tinyfpga/TinyFPGA-EX/README.md

# TinyFPGA-EX
Small, but powerful FPGA development board based on the Lattice ECP5.
