tinyfpga/TinyFPGA-EX/board/TinyFPGA-EX.kicad_pcb

## KiCad design board/TinyFPGA-EX.kicad_pcb (2019-02-04)

Schematic: TinyFPGA-EX.sch

Parts:
C1, C17, C20, C42, C43: 1uF; C_0402_NoSilk
C2, C3, C6, C9, C10, C13, C15, C18, C24, C26, C28, C29, C30, C34, C39, C41, C44, C45, C46, C47: 100nF; C_0402_NoSilk
C4, C7, C11, C12, C14, C16, C31, C35: 10nf; C_0402_NoSilk
C5, C23: 10uF; C_0603
C8, C38, C40: 10nF; C_0402_NoSilk
C19: 2.2uF; C_0402_NoSilk
C22: 22uF; C_0603
C33: 10uF; C_0402_NoSilk
C36, C37: 1nF; C_0402_NoSilk
D1, D2: LED; LED_0603
J1: Conn_02x03_Odd_Even
J2: Micro_SD_Card_Det_Hirose_DM3AT; DM3D-SF
J3: USBC
J4, J5: Conn_01x24; Pin_Header_Straight_1x24_Pitch2.54mm
J6: Conn_02x09_Odd_Even
J7: Conn_01x06
L1: 330nH; L_Vishay_IHLP-1616
L2: 1uH; L_Wuerth_MAPI-2010
R3, R8: 0; R_0402_NoSilk
R4, R5, R7, R10: 4.7k; R_0402_NoSilk
R6: 100K; R_0402_NoSilk
R11: 1.5k; R_0402_NoSilk
R12, R13: 4.7K; R_0402_NoSilk
SW1: SW_Push; PTS_810_SMT_Switch
TP1, TP11, TP12, TP13: TEST; small-testpoint
U1: LFE5UM-285
U2: S27KS0641DPBHI020; FBGA-24
U3: DSC6001CI2A-016.0000T; CDFN3225-4LD-PL-1
U4: FAN53555; WLCSP-20
U5: MIC5504-2.5YMT-TR; Thin-DFN4
U6: Conn_02x03_Counter_Clockwise
U7: FAN53600; WLCSP-6
U8: S25FL064L; UNF008
U9: MIC5504-1.2YMT-TR; Thin-DFN4
U10, U11: PUSB3FR4Z

Connections:
+1V1: C10.1, C12.1, C13.1, C14.1, C15.1, C16.1, C22.1, L1.2, U1.C8, U1.C9, U1.C10, U1.C11, U1.D8, U1.D9, U1.D10, U1.D11, U1.J3, U1.J4, U1.J5, U1.J14, U1.J15, U1.J16, U1.K3, U1.K4, U1.K15, U1.K16, U1.L3, U1.L4, U1.L15, U1.L16, U1.M3, U1.M4, U1.M15, U1.M16, U1.P7, U1.P9, U1.P11, U4.A4; also elsewhere on the board
+1V2A: C36.1, C37.1, C38.1, C39.1, C40.1, C41.1, C43.1, TP1.1, U1.P10, U1.R10, U1.T5, U1.U6, U1.U8, U1.U12, U9.1
+2V5: C6.1, C7.1, C20.1, TP13.1, U1.E6, U1.E13, U1.N6, U1.P5, U1.P13, U1.R3, U5.1
+5V: C5.1, C8.1, C19.1, J3.A4, J3.A9, J3.B4, J3.B9, J5.1, R3.1, U4.A2, U4.D1, U4.D2, U4.E1, U4.E2, U7.A2, U7.B2
CC1: J3.A5
CC2: J3.B5
CFG_MODE_SEL_0: R7.1, U1.U14, U1.V15
CFG_MODE_SEL_1: R5.2, U1.T14
CH0_RXN: J3.A10, U1.V8, U10.2, U10.9
CH0_RXP: J3.A11, U1.V9, U10.1, U10.10
CH0_TXN: C47.2, U1.V11, U11.2, U11.9
CH0_TXP: C45.2, U1.V12, U11.1, U11.10
CH1_RXN: J3.B11, U1.V5, U11.5, U11.6
CH1_RXP: J3.B10, U1.V6, U11.4, U11.7
CH1_TXN: C46.2, U1.V2, U10.5, U10.6
CH1_TXP: C44.2, U1.V3, U10.4, U10.7
CLK_16MHz: U1.B17, U3.3
CSSPIN: U1.U17, U8.1; also elsewhere on the board
DONE: U1.U15
GND: C1.2, C2.2, C3.2, C4.2, C5.2, C6.2, C7.2, C8.2, C9.2, C10.2, C11.2, C12.2, C13.2, C14.2, C15.2, C16.2, C17.2, C18.2, C19.2, C20.2, C22.2, C23.2, C24.2, C26.2, C28.2, C29.2, C30.2, C31.2, C33.2, C34.2, C35.2, C36.2, C37.2, C38.2, C39.2, C40.2, C41.2, C42.2, C43.2, J1.3, J2.6 (VSS), J2.11 (SHIELD), J3.A1, J3.A12, J3.B1, J3.B12, J4.1, J5.2, J5.15, J6.1, R4.2, R6.2, R7.2, R8.2, R12.2, R13.2, SW1.1, U1.B3, U1.B16, U1.E5, U1.E7, U1.E8, U1.E9, U1.E10, U1.E11, U1.E12, U1.E14, U1.F5, U1.F6, U1.F7, U1.F8, U1.F9, U1.F10, U1.F11, U1.F12, U1.F13, U1.F14, U1.G2, U1.G6, U1.G7, U1.G8, U1.G9, U1.G10, U1.G11, U1.G12, U1.G13, U1.G17, U1.H6, U1.H7, U1.H8, U1.H9, U1.H10, U1.H11, U1.H12, U1.H13, U1.J6, U1.J7, U1.J8, U1.J9, U1.J10, U1.J11, U1.J12, U1.J13, U1.K5, U1.K6, U1.K7, U1.K8, U1.K9, U1.K10, U1.K11, U1.K12, U1.K13, U1.K14, U1.L2, U1.L5, U1.L6, U1.L7, U1.L8, U1.L9, U1.L10, U1.L11, U1.L12, U1.L13, U1.L14, U1.L17, U1.M6, U1.M7, U1.M8, U1.M9, U1.M10, U1.M11, U1.M12, U1.M13, U1.N7, U1.N8, U1.N9, U1.N10, U1.N11, U1.N12, U1.P6, U1.P8, U1.P12, U1.R1, U1.R2, U1.T2, U1.T3, U1.T4, U1.T6, U1.T7, U1.T8, U1.T9, U1.T10, U1.T11, U1.T12, U1.T16, U1.U2, U1.U3, U1.U4, U1.U5, U1.U7, U1.U9, U1.U10, U1.U11, U1.V4, U1.V7, U1.V10, U2.B3, U2.C1, U2.E5, U3.2, U4.A3, U4.B1, U4.B2, U4.B3, U4.B4, U4.C1, U4.C2, U4.C3, U4.C4, U5.2, U6.3, U7.A1, U7.C2, U8.4, U9.2, U10.3, U10.8, U11.3, U11.8
INITN: U1.V16
IO2: U1.R18, U8.3
IO3: U1.N18, U8.7
MISO: U1.T18, U8.2; also elsewhere on the board
MOSI: U1.U18, U8.5; also elsewhere on the board
unnamed: C44.1, J3.A3
unnamed: C45.1, J3.B2
unnamed: C46.1, J3.A2
unnamed: C47.1, J3.B3
unnamed: D1.1, R12.1
unnamed: D2.1, R13.1
unnamed: L1.1, U4.D3, U4.D4, U4.E3, U4.E4
unnamed: L2.1, U7.B1
unnamed: R3.2, R8.1, U4.A1
PIN1: J4.2, U1.F18
PIN2: J4.3, U1.H17
PIN3: J4.4, U1.H18
PIN4: J4.5, U1.J17
PIN5: J4.6, U1.N17
PIN6: J4.7, U1.M18
PIN7: J4.8, U1.M17
PIN8: J4.9, U1.G18
PIN9: J4.10, U1.D18
PIN10: J4.11, U1.B18
PIN11: J4.12, U1.A17
PIN12: J4.13, U1.A16
PIN13: J4.14, U1.B15
PIN14: J4.16, U1.A15
PIN15: J4.17, U1.A13
PIN16: J4.18, U1.B13
PIN17: J4.19, U1.D15
PIN18: J4.20, U1.C15
PIN19: J4.21, U1.A11
PIN20: J4.22, U1.B11
PIN21: J4.23, U1.A12
PIN22: J4.24, U1.B12
PIN23: J5.24, U1.B8
PIN24: J5.23, U1.B7
PIN25: J5.22, U1.C4
PIN26: J5.21, U1.B1
PIN27: J5.20, U1.A3
PIN28: J5.19, U1.C2
PIN29: J5.18, U1.C1
PIN30: J5.17, U1.D1
PIN31: J5.16, U1.D3
PIN32: J5.14, U1.R17
PIN33: J5.13, U1.V17
PIN34: J5.12, U1.R16
PIN35: J5.11, U1.J18
PIN36: J5.10, U1.K17
PIN37: J5.9, U1.K18
PIN38: J5.8, U1.L18
PIN39: J5.7, U1.N16
PIN40: J5.6, U1.C17
PIN41: J5.5, U1.C18
PIN42: J5.4, U1.D17
PIN43: J6.21, U1.C3
PIN44: J6.19, U1.F4
PIN45: J6.17, U1.N4
PIN46: J6.15, U1.B6
PIN47: J6.13, U1.A6
PIN48: D2.2, J6.11, U1.A7
PIN49: J6.10, U1.A2
PIN50: J6.12, U1.B2
PIN51: J6.14, U1.B4
PIN52: J6.16, U1.D2
PIN53: J6.18, U1.N3
PIN54: J6.20, U1.N2
PIN55: J6.22, U1.N1
PROGRAMN: R10.2, SW1.2, TP11.1, U1.T15, U1.T17
RAM_CK+: U1.F1, U2.B2
RAM_CS_B: U1.H1, U2.A3
RAM_DQ0: U1.J1, U2.D3
RAM_DQ1: U1.G1, U2.D2
RAM_DQ2: U1.K1, U2.C4
RAM_DQ3: U1.M2, U2.D4
RAM_DQ4: U1.M1, U2.D5
RAM_DQ5: U1.L1, U2.E3
RAM_DQ6: U1.F2, U2.E2
RAM_DQ7: U1.F3, U2.E1
RAM_RESET_B: U1.K2, U2.A4
RAM_RWDS: U1.J2, U2.C3
SBU1: J3.A8, TP12.1
SBU2: J3.B8; also elsewhere on the board
SCK: U1.U16, U8.6; also elsewhere on the board
SDCARD_CLK: J2.5 (CLK), J6.3, U1.B10
SDCARD_CMD: J2.3 (CMD), J6.8, U1.A4
SDCARD_DAT0: J2.7 (DAT0), J6.5, U1.A10
SDCARD_DAT1: J2.8 (DAT1), J6.7, U1.A9
SDCARD_DAT2: J2.1 (DAT2), J6.4, U1.A8
SDCARD_DAT3_CD: J2.2 (DAT3/CD), J6.6, U1.D4
SDCARD_DET: J2.9 (DET_B), J6.9, R6.1, U1.B9
TCK: J1.2, R4.1, U1.U13
TDI: J1.4, U1.T13
TDO: J1.5, U1.V14
TMS: J1.6, U1.V13
USB3_REFCLK_0: U1.U1, U6.4
USB3_REFCLK_1: U1.T1, U6.5
USB_CONNECT: R11.1, U1.C16
USB_D+: J3.A6, J3.B6, R11.2, U1.D16; also elsewhere on the board
USB_D-: J3.A7, J3.B7, U1.F17; also elsewhere on the board
VCCIO0: C1.1, C2.1, C3.1, C4.1, C9.1, C11.1, C17.1, C18.1, C23.1, C24.1, C26.1, C28.1, C29.1, C30.1, C31.1, C33.1, C34.1, C35.1, C42.1, D1.2, J1.1, J2.4 (VDD), J2.10 (DET_A), J4.15, J5.3, J6.2, L2.2, R5.1, R10.1, U1.C6, U1.C7, U1.C12, U1.C13, U1.D6, U1.D7, U1.D12, U1.D13, U1.G4, U1.G5, U1.G14, U1.G15, U1.H4, U1.H5, U1.H14, U1.H15, U1.M5, U1.M14, U1.N5, U1.N13, U1.N14, U1.N15, U1.P14, U2.B4, U2.D1, U2.E4, U3.1, U3.4, U5.3, U5.4, U6.1, U6.6, U7.C1, U8.8, U9.3, U9.4

Notes on the sheet:
Select SPI Master Configuration Mode by setting CFG[2:0] == 3'b010
ECP5 Hardware Checklist recommends using a pull-up on this pin if the FPGA will be using it to handshake with other devices. However, this pin will not be used and should not need an external pull-up.
JTAG Header
Voltage Regulator Tree
1.2 Volt Switching Regulator
3.3 Volt Switching Regulator
2.5 Volt LDO Regulator
JTAG
FPGA Power Supply Connections and Decoupling
FPGA Bitstream Configuration
SPI Configuration Flash
Micro SD Card Slot
HyperRAM
System Clock
USB Type-C Connector
Board Connectors and FPGA IOs
Channel 1 polarity is inverted
1.2 Volt LDO Regulator
USB3 Reference Clock
Place R3 for 1.2v operation Place R8 for 1.1v operation
USB3 FPGA SERDES
Low Speed Signal Breakout
Bottom Header
1.2v LDO is only used for boards with SERDES
Bootloader Button
Power and Status LEDs

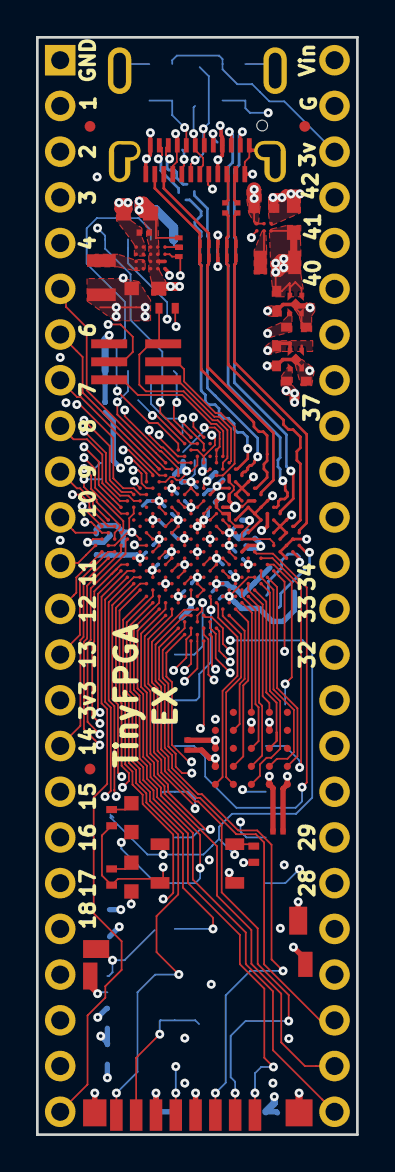
[picture p1: board TinyFPGA-EX.kicad_pcb from above]

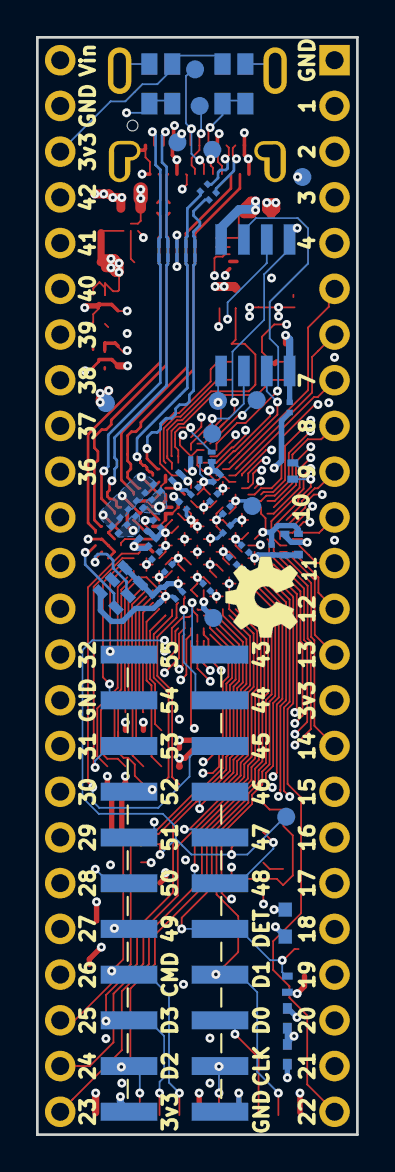
[picture p2: board TinyFPGA-EX.kicad_pcb from below]

Board: 6 copper layers, 17.8 x 61.0 mm, 87 parts (51 on the bottom side), 118 nets.

Other parts of the board:
TP12#2, TP12#3, TP12#4, TP12#5, TP12#6, TP12#7, TP12#8, TP12#9: TEST; small-testpoint

Their connections:
+1V1: TP12#9.1; also elsewhere on the board
CSSPIN: TP12#6.1; also elsewhere on the board
MISO: TP12#5.1; also elsewhere on the board
MOSI: TP12#7.1; also elsewhere on the board
SBU2: TP12#2.1; also elsewhere on the board
SCK: TP12#8.1; also elsewhere on the board
USB_D+: TP12#4.1; also elsewhere on the board
USB_D-: TP12#3.1; also elsewhere on the board
