tinyfpga/TinyFPGA-EX/(commit log)

2018-11-28 putting TinyFPGA EX on github
    [TinyFPGA-EX.kicad_pcb, TinyFPGA-EX.sch]
2019-02-02 latest tweaks
    [TinyFPGA-EX.kicad_pcb, TinyFPGA-EX.sch]
2019-02-04 minor updates for rev c
    [TinyFPGA-EX.kicad_pcb]
